dehre/fpga-spi-fifo/schematics/arduino-fpga.kicad_sch.pdf

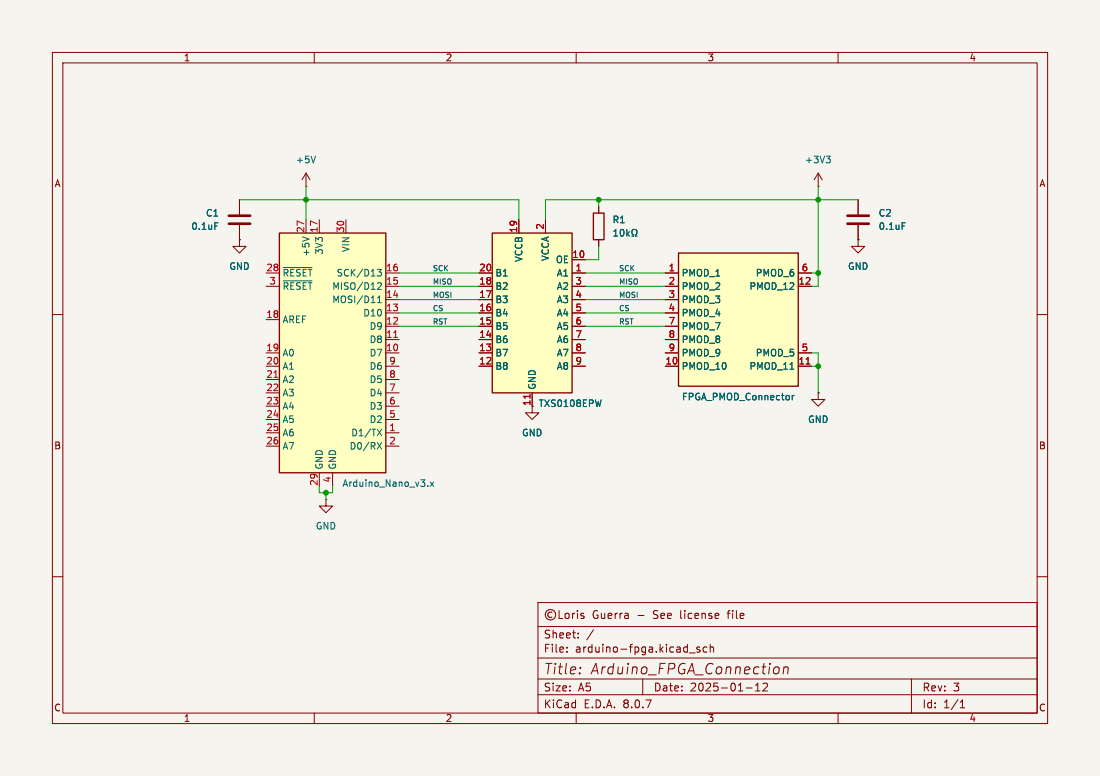
[picture p3: page 1]

File: arduino-fpga.kicad_sch Sheet: / þÿ©Loris Guerra - See license file
