dehre/fpga-spi-fifo/(commit log)

2024-09-28 stage-1: count rising edges on PMOD pin 1 using onboard LEDs
2024-10-06 stage-1: upload schematics
2024-10-20 stage-2: count rising edges on PMOD pin 1 using 7-segment displays
2024-10-20 stage-2: same schematics as stage-1
2024-11-17 stage-3: create an spi slave loopback device using PMOD pins
2024-11-17 stage-3: upload updated schematics
2024-12-29 stage-4: create fifo queue and design state machine around it
2024-12-29 stage-4: same schematics as stage-3
2025-01-05 stage-5: remove unused entities and show fifo-count on the 7-segment displays
2025-01-12 stage-5: remove unused pins and update spi-clock period in constraint files
2025-01-12 stage-5: upload updated schematics
2025-01-26 stage-6: write additional testbenches
2026-04-02 stage-6: rename rtl dir
